steflayanto/Tricopter/Tricopter Specs.xlsx

Sheet: Technical Specs
 | Arduino Copter
Flight Weight (grams) | 825
Arm Radius (cm) | 30
Prop
Prop Centre Radius (cm) | 25.5
Prop Type | APC 6x4E LP0604E
Max Thrust (grams) | 1350 | Flight Time | Amps | AH | mAH
Theoretical Flight Time (seconds) | 2:00 - 3:25 | 5 | 12 | 3 | 3000
Flight Controller | Arduino Uno
Accelerometer | DFR Robot BMA220
Gyroscope | SparkFun ITG3200
Servo | KDS 9G Digital Servo
Output Torque | 1.4kg.cm(4.8V) @1.8kg.cm(6.0V)
Speed | 0.09sec/60(4.8V) @0.07sec/60(6.0V)
Rating Voltage | 4.8-6V
Operating Temperature | -20 - 60C
Weight | 9G
Dimensions | 24x12x24mm
Motor | A2212/6T 2200KV
Shaft diameter (mm) | 3
KV (RPM/V) | 2200
Max Efficiency Current (Amps) | 14 - 22
Max Current | 28A for 60s
No load current (Amps) | 1.2
Dimensions (cm) | 3.7 x 2.8 x 2.8
Weight (grams) | 49
Total Motors Current (Amps) | 42 - 66
Total Motors Max Current | 84A for 60s
Battery | UltraPulse LiPo
Cells | 3S (11.1V) | Note: Avoid Discharging Battery Below 80% C
Capacity (mAH) | 2200
Discharge Rate | 25C or 55A
Charge Rate | < 5C or < 11A
Weight (grams) | 200
Reciever | FlySky FS-R9B
Channels | 8
Frequency | 2.4GHz
Weight (grams) | 18
Transmitter | FlySky FS-TH9X
ESC | Ztw Beatles 30A ESC
Continuous Current (Amps) | 30
Burst Current (Amps) | 40
BEC Output | 5V/2A
Weight (grams) | 24
Charger
Charge Rate | 1-3A
Charge Time (1A)
Charge Time (2A) | 40:00:00
Charge Time (3A)

Sheet: Sheet1
Servo Neutral Position |  | 1370micros
Servo Range |  | 700-1835
Angle Range
Motor Arming |  | 770us interval
Servo Angles | Middle | 1400 | 420 | 1400
 | 35 | 980
 | -35 | 1820 | 420

Sheet: Radio PWM Ranges
Function | Channel | Min | Middle | Max
Throttle | 2 | 1055 | 1460 | 1885
Pitch | 4 | 1055 | 1460 | 1880
Roll | 3 | 1040 | 1460 | 1875
Yaw | 1 | 1045 | 1460 | 1875
Aux5 | 5 | 1025 | N/A | 1855
Aux6 | 6 | 1025 | 1445 | 1865

Sheet: Pin Assignments
Pin | Assignment | Description
0
1
2
~3 | Radio Ch1
4 | Radio Ch2
~5 | Radio Ch3
~6 | Left ESC
7 | Radio Ch4
8 | Radio Aux5
~9 | Right ESC
~10 | Back ESC
~11 | Back Servo
12
13
GND
3.3V
5V
GND
GND
Vin
A0
A1
A2
A3
A4
A5

Sheet: Thrust Stat Tests
Scale (0 - 1000) | Micros | Servo | Weight 1 | Weight 2 |  |  | Ave Weight | Thrust
0 | 700 | 0 | 1160 | 1160 |  |  | 1160 |  | Omitted
55.55555556 | 772.2222222 | 10 | 1160 | 1160 |  |  | 1160 |  | Omitted
111.1111111 | 844.4444444 | 20 | 1160 |  |  |  | 1160 |  | Omitted
166.6666667 | 916.6666667 | 30 | 1160 |  |  |  | 1160 | 0
222.2222222 | 988.8888889 | 40 | 1140 |  |  |  | 1140 | 20
277.7777778 | 1061.111111 | 50 | 1110 |  |  |  | 1110 | 50
333.3333333 | 1133.333333 | 60 | 1070 | 1050 |  |  | 1060 | 100
388.8888889 | 1205.555556 | 70 | 1040 | 1000 | 1020 |  | 1020 | 140
444.4444444 | 1277.777778 | 80 | 1000 | 1000 |  |  | 1000 | 160
500 | 1350 | 90 | 980 | 950 |  |  | 965 | 195
555.5555556 | 1422.222222 | 100 | 950 | 940 |  |  | 945 | 215
611.1111111 | 1494.444444 | 110 | 930 | 900 |  |  | 915 | 245
666.6666667 | 1566.666667 | 120 | 900 | 880 |  |  | 890 | 270
722.2222222 | 1638.888889 | 130 | 890 | 860 |  |  | 875 | 285
777.7777778 | 1711.111111 | 140 | 860 | 850 |  |  | 855 | 305
833.3333333 | 1783.333333 | 150 | 850 | 750 |  |  | 800 | 360
888.8888889 | 1855.555556 | 160 |  | 750 |  |  | 750 | 410
944.4444444 | 1927.777778 | 170 |  | 720 |  |  | 720 | 440
1000 | 2000 | 180 |  | 740 |  |  | 740 | 420
 | Prop | Volts | Amps | Watts | rpm | Thrust | Efficiency
 | APC 6x4E | 10.5 | 22 | 230 | 18786 | 680g | 75%
 | Source: http://www.bhabbott.net.nz/A2212-6.html
 | Experimental Max Amp Draw
 | Single Motor |  | 22A
 | Triple Motors |  | 66A

Sheet: Program
Name | Type | Category | Tabs Used In | Range | Description
centerOfThrust[2] | Float Array | Radio Input/PID | Main, Convert Output | -15.0 to 15.0 (for both axis) | Coordinates visualizing the center of thrust from a top down view of a 2 dimensional cartesian grid.
headingThrust | float | Output Conversions | Convert Output | -40.0 to 40.0 | Rotational Output force in % of total motor thrust. Limited to 40% since hovering thrust around 80%, and applying more than 40% rotational thrust will cause servo angle to exceed 30 deg

Sheet: Loop Speed
Baud Rate | 250000 |  |  |  | 115200
Loop Duration (microsec) | 1235 | 10800 | 11000 | 11700 | 11700
Frequency | 809.7165992 | 92.59259259 | 90.90909091 | 85.47008547 | 85.47008547 | #DIV/0! | #DIV/0! | #DIV/0! | #DIV/0! | #DIV/0! | #DIV/0! | #DIV/0! | #DIV/0! | #DIV/0! | #DIV/0! | #DIV/0! | #DIV/0! | #DIV/0! | #DIV/0! | #DIV/0! | #DIV/0! | #DIV/0! | #DIV/0! | #DIV/0!
Errors |  |  |  | Yes
Display Functions | Yes
getOrientation |  | Yes | Yes | Yes
CheckForInput |  |  | Yes | Yes
ReadRadioMAF |  |  |  | Yes
