steflayanto/Tricopter/References, Diagrams, Manuals/Propellers.pdf

FUND TRANSFER RECEIPT
Date | : | 25/08/2017
Time | : 16:36:44
Reference Number | : | 15AFC571-A2FC-5A56-0FAA-12D2274A1E6B
Virtual Account Number | : 80008081215524236
Name | : | Stefan Layanto
Company/Product Name | : BUKALAPAK
BL17114EHOKDINV | : | 134.500,00
Billing Total | : | 134.500,00
Sequence Number | : | 601900
Status | : | TRANSACTION SUCCESS
Copyright © 2000 | All Rights Reserved
