steflayanto/Tricopter/References, Diagrams, Manuals/Accel Graph Screenshots/Accel64Hz runningMAF15.png

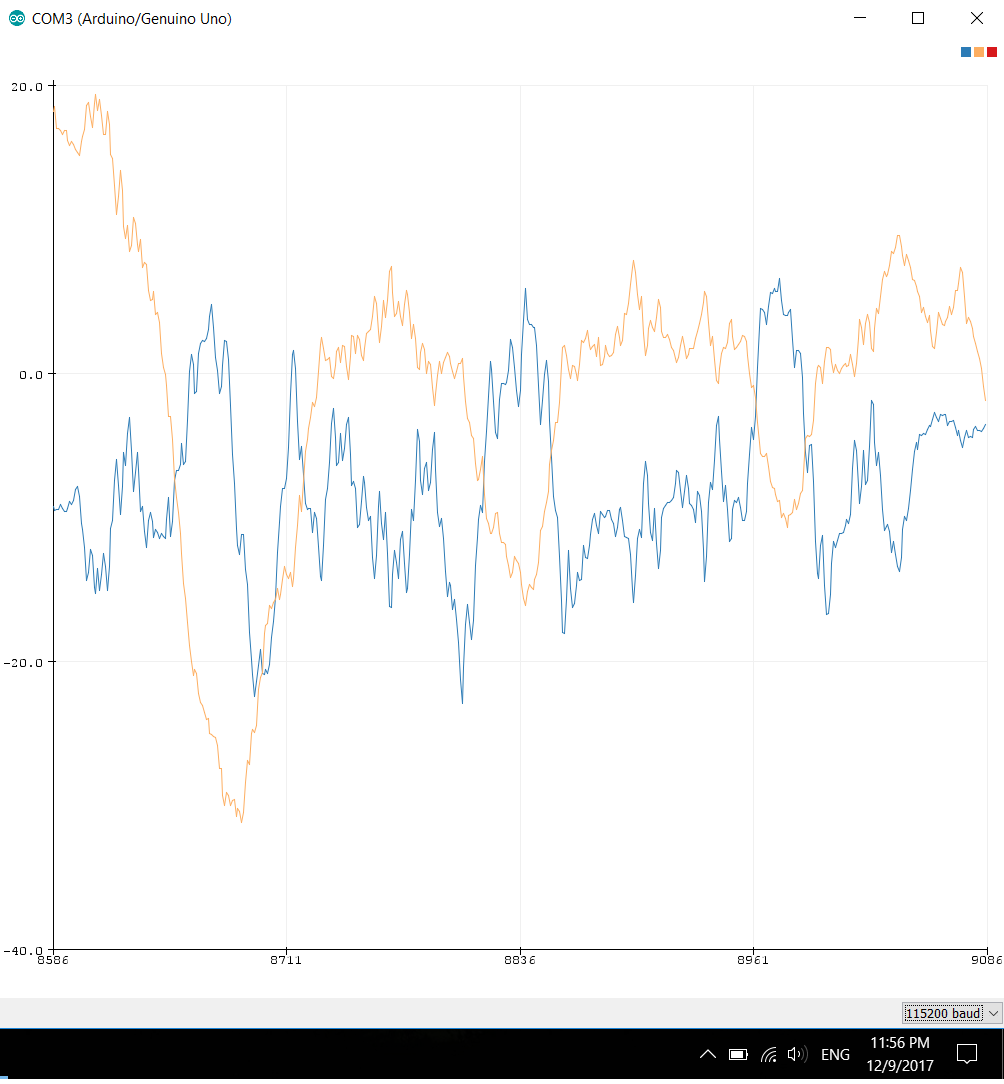
References, Diagrams, Manuals/Accel Graph Screenshots/Accel64Hz runningMAF15.png
