steflayanto/Tricopter/References, Diagrams, Manuals/Accel Graph Screenshots/Accel250Hz runningMAF15.png

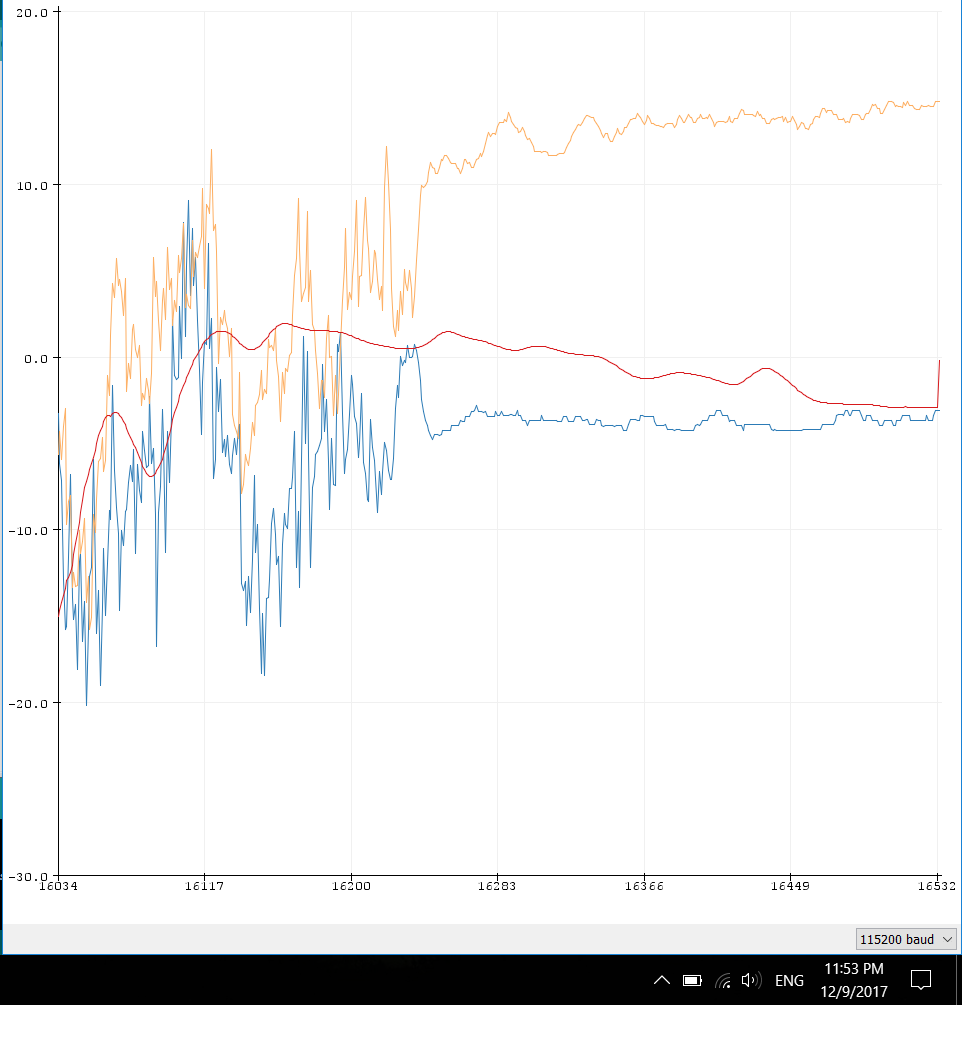
References, Diagrams, Manuals/Accel Graph Screenshots/Accel250Hz runningMAF15.png
