steflayanto/Tricopter/References, Diagrams, Manuals/Accel Graph Screenshots/Accel500Hz running MAF 30.png

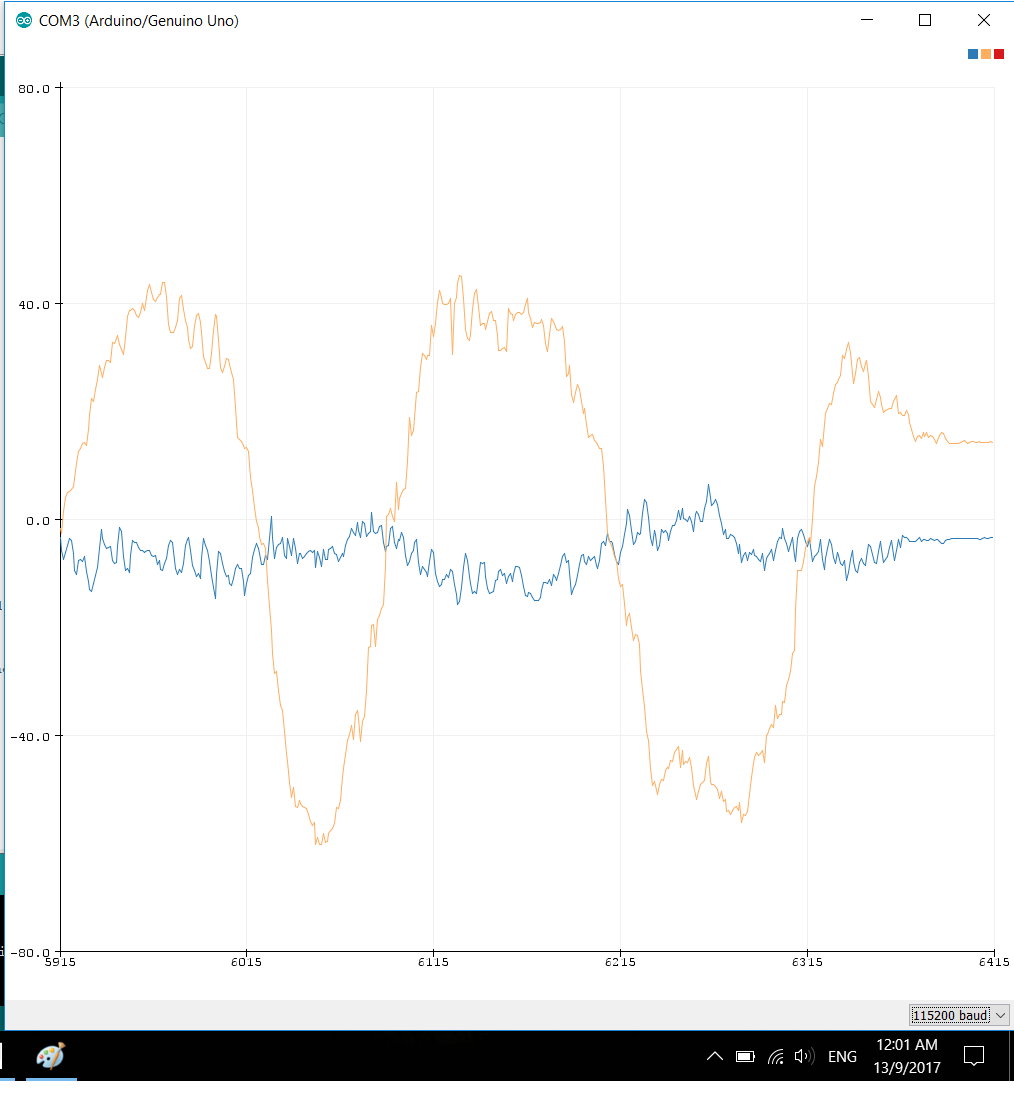
References, Diagrams, Manuals/Accel Graph Screenshots/Accel500Hz running MAF 30.png
