steflayanto/Tricopter/References, Diagrams, Manuals/Accel Graph Screenshots/Accel ForcedTilt 64Hz 10MAF.png

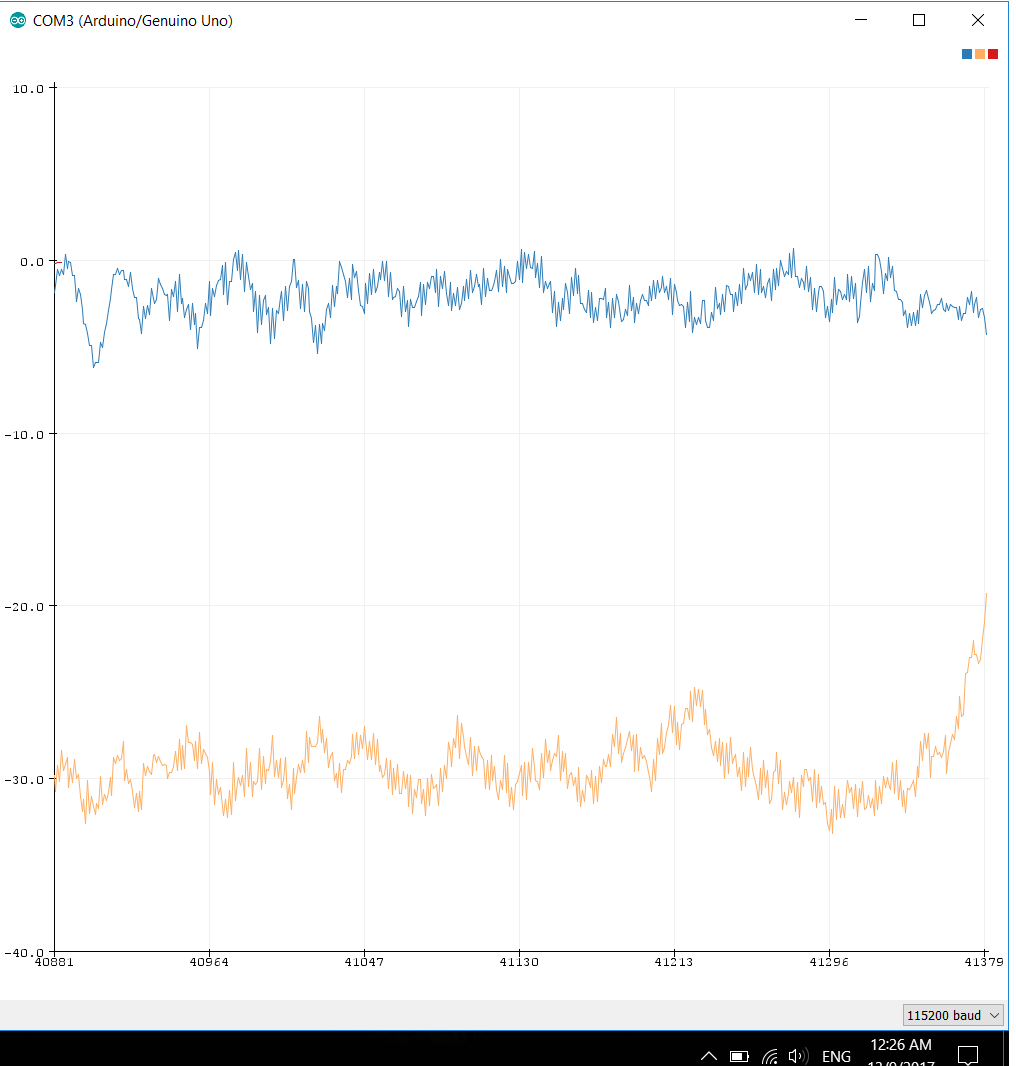
References, Diagrams, Manuals/Accel Graph Screenshots/Accel ForcedTilt 64Hz 10MAF.png
