steflayanto/Tricopter/References, Diagrams, Manuals/Accel Graph Screenshots/Accel ForcedTilt 125Hz 20MAF.png

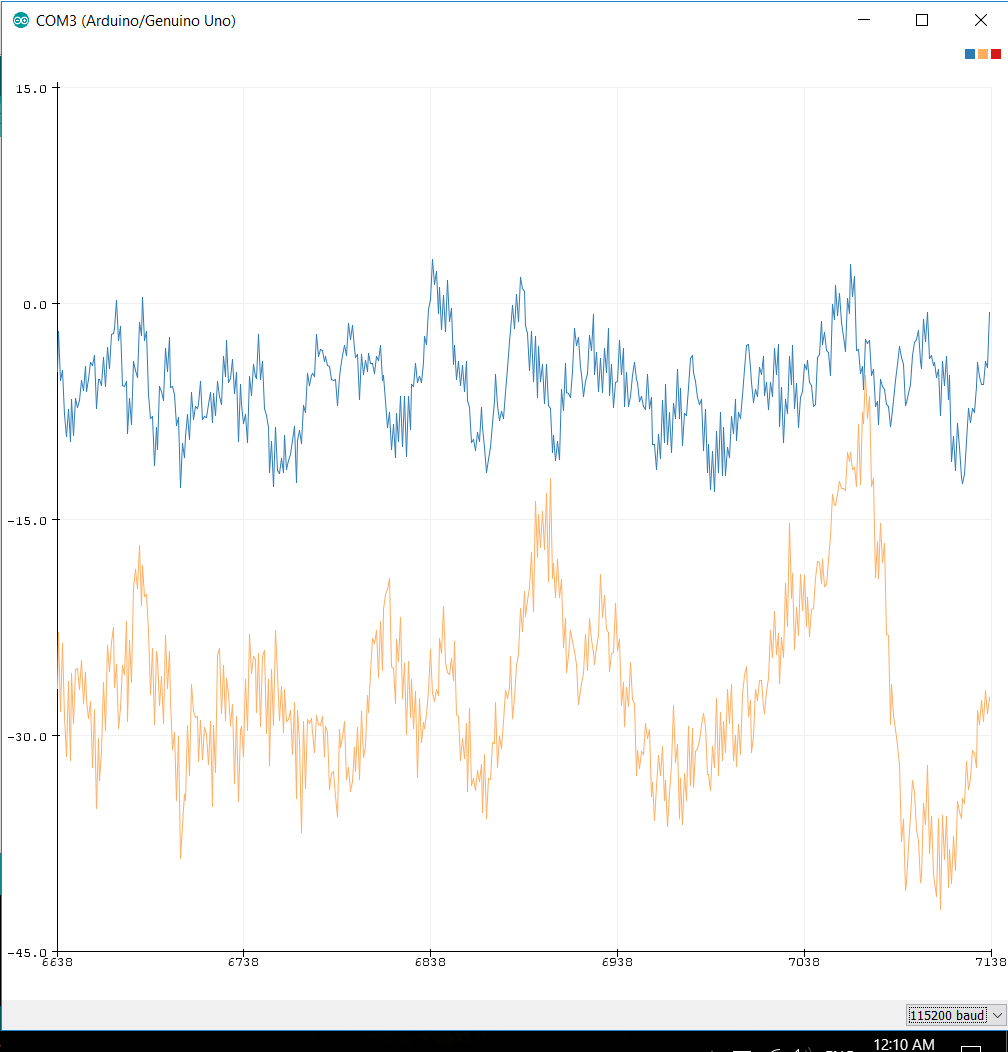
References, Diagrams, Manuals/Accel Graph Screenshots/Accel ForcedTilt 125Hz 20MAF.png
