steflayanto/Tricopter/References, Diagrams, Manuals/Accel Graph Screenshots/Accel ForcedTilt 250Hz 15MAF New Dampener.png

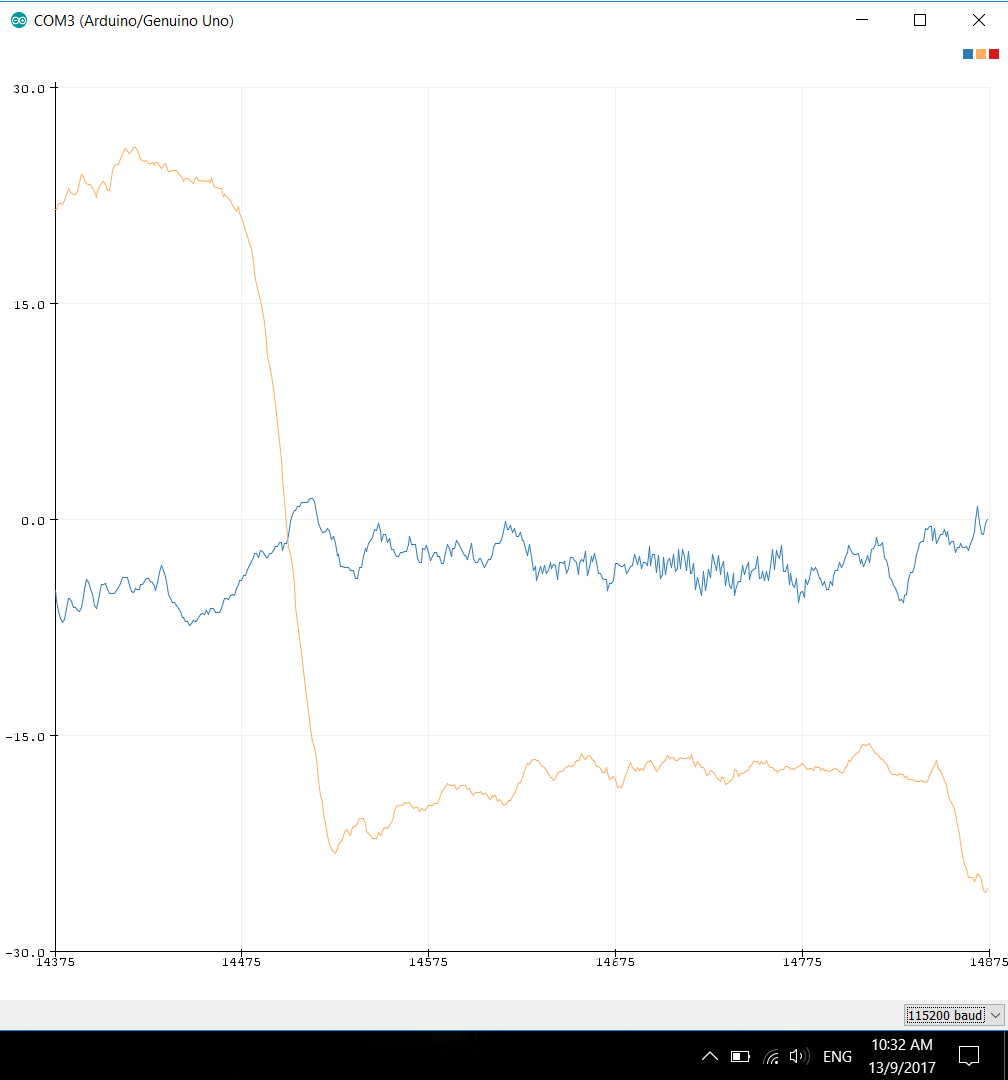
References, Diagrams, Manuals/Accel Graph Screenshots/Accel ForcedTilt 250Hz 15MAF New Dampener.png
