steflayanto/Tricopter/References, Diagrams, Manuals/Accel Graph Screenshots/Accel ForcedTilt 250Hz 20MAF.png

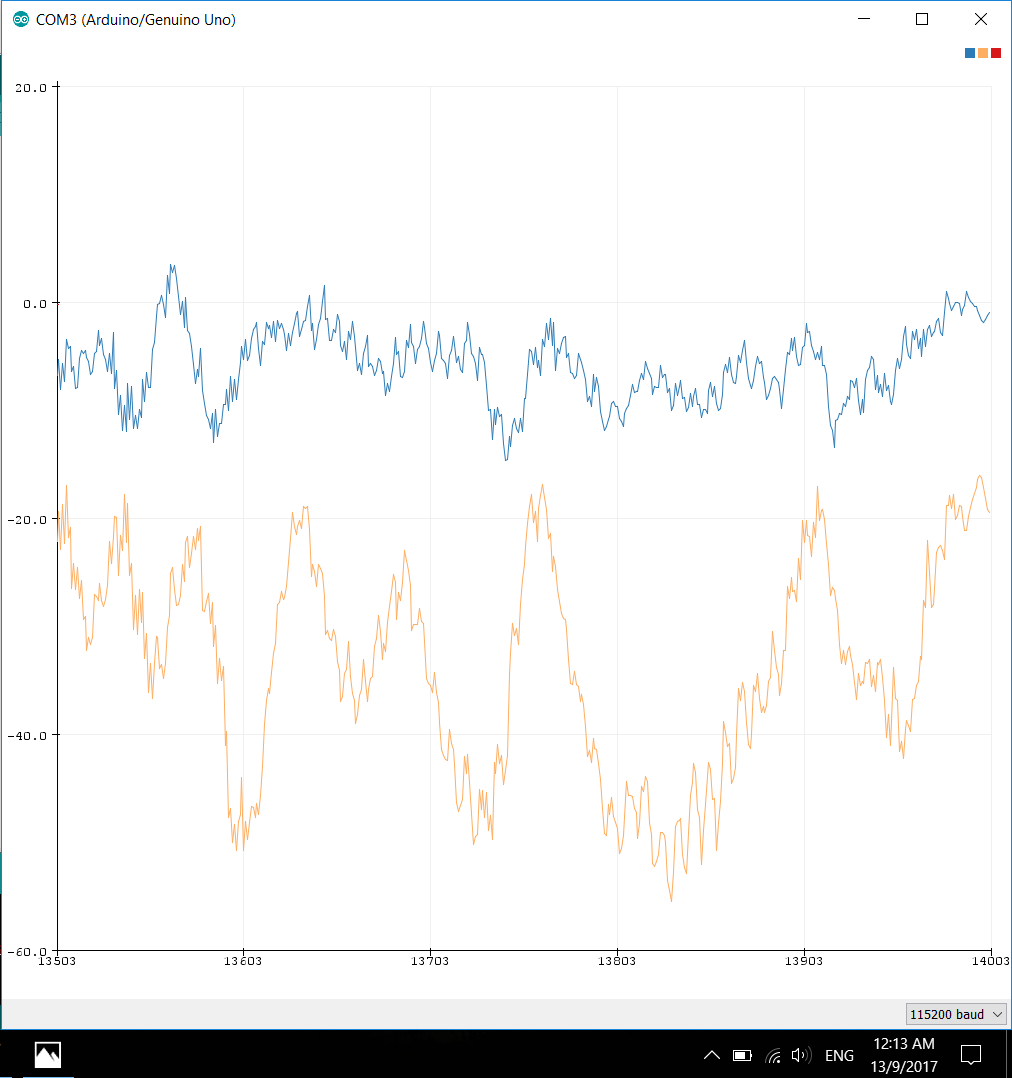
References, Diagrams, Manuals/Accel Graph Screenshots/Accel ForcedTilt 250Hz 20MAF.png
