steflayanto/Tricopter/References, Diagrams, Manuals/Accel Graph Screenshots/Accel ForcedTilt 500Hz 20MAF.png

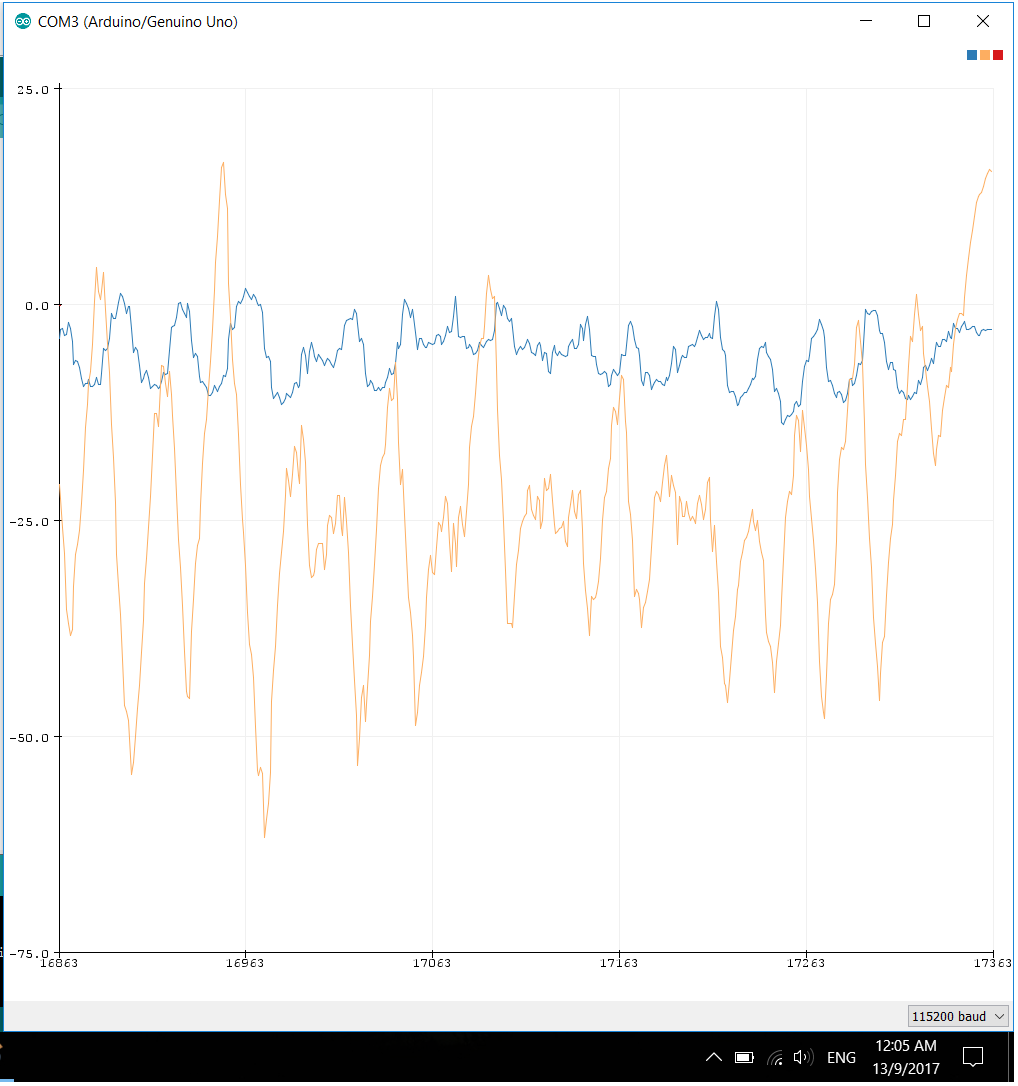
References, Diagrams, Manuals/Accel Graph Screenshots/Accel ForcedTilt 500Hz 20MAF.png
