steflayanto/Tricopter/References, Diagrams, Manuals/Accel Graph Screenshots/Resting Accel Data 100 Hz Sample.png

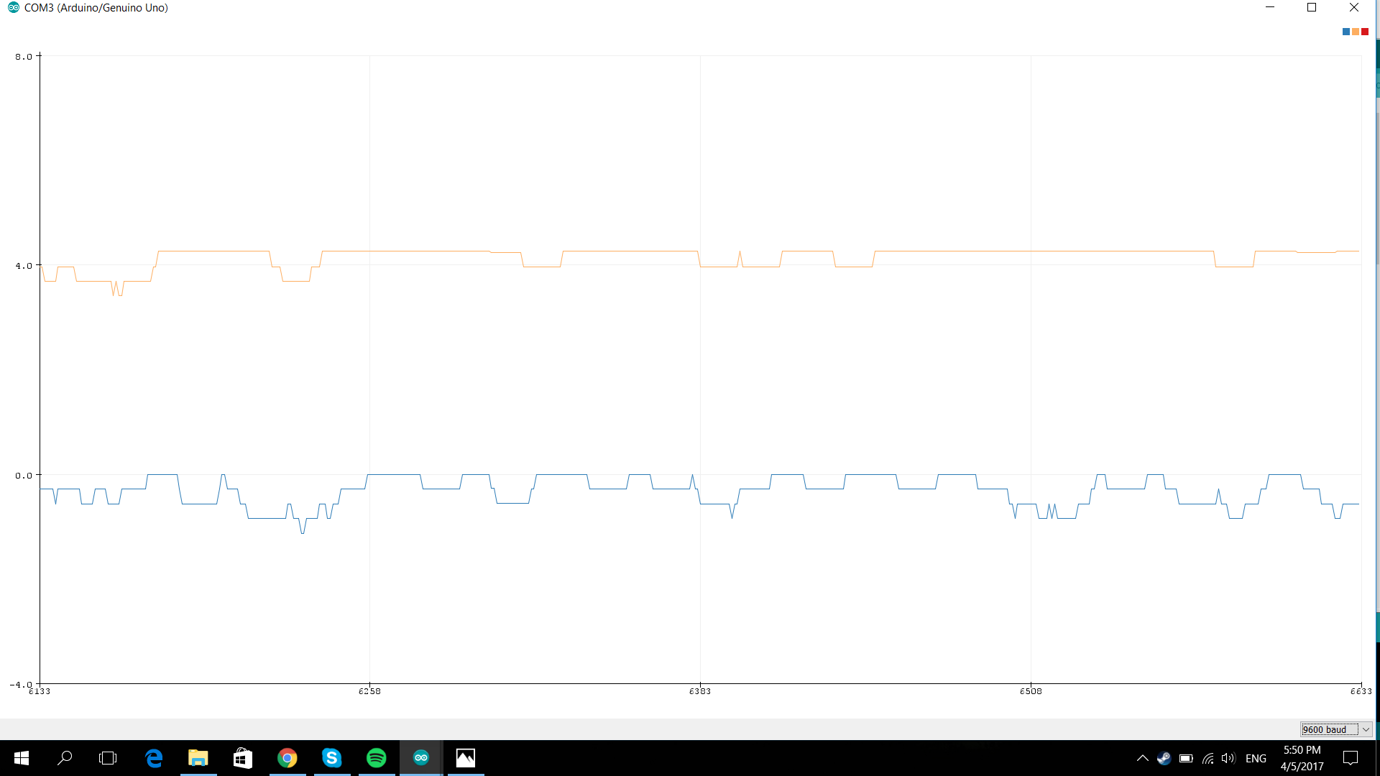
References, Diagrams, Manuals/Accel Graph Screenshots/Resting Accel Data 100 Hz Sample.png
