steflayanto/Tricopter/References, Diagrams, Manuals/Accel Graph Screenshots/Resting Accel Data 250 Hz Sample.png

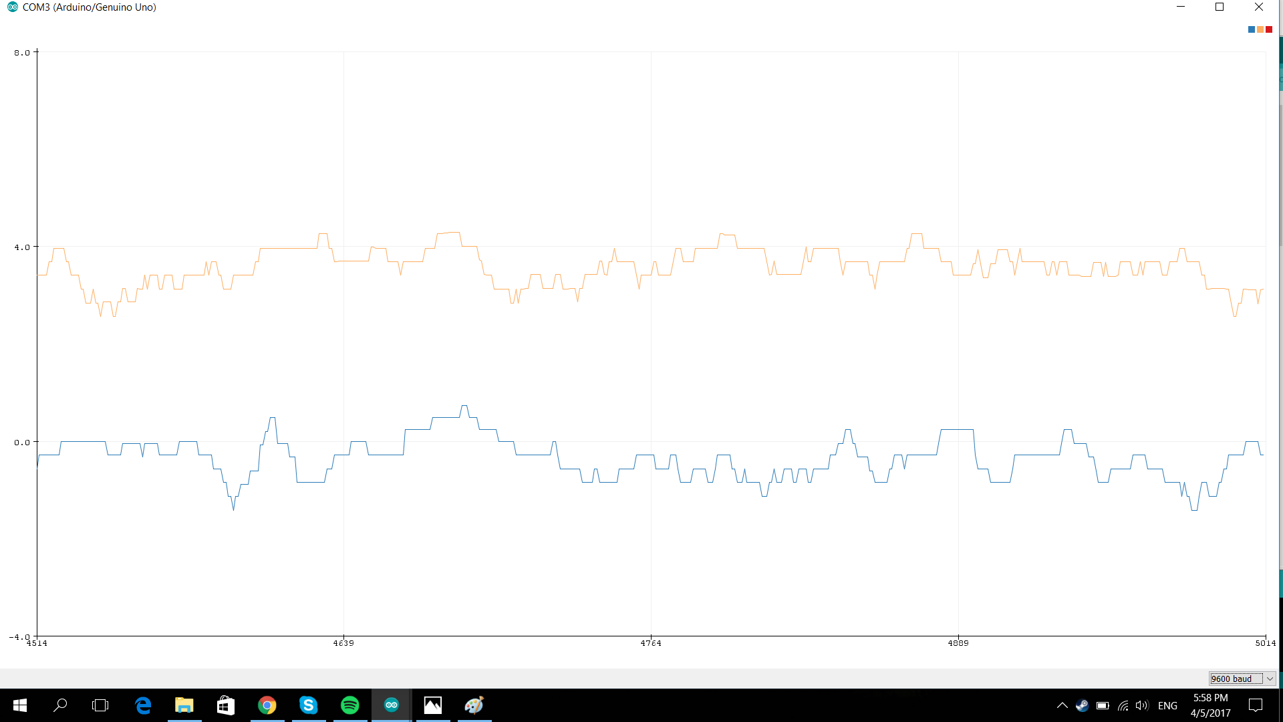
References, Diagrams, Manuals/Accel Graph Screenshots/Resting Accel Data 250 Hz Sample.png
