steflayanto/Tricopter/References, Diagrams, Manuals/Accel Graph Screenshots/Resting Accel Data 500 Hz Sample.png

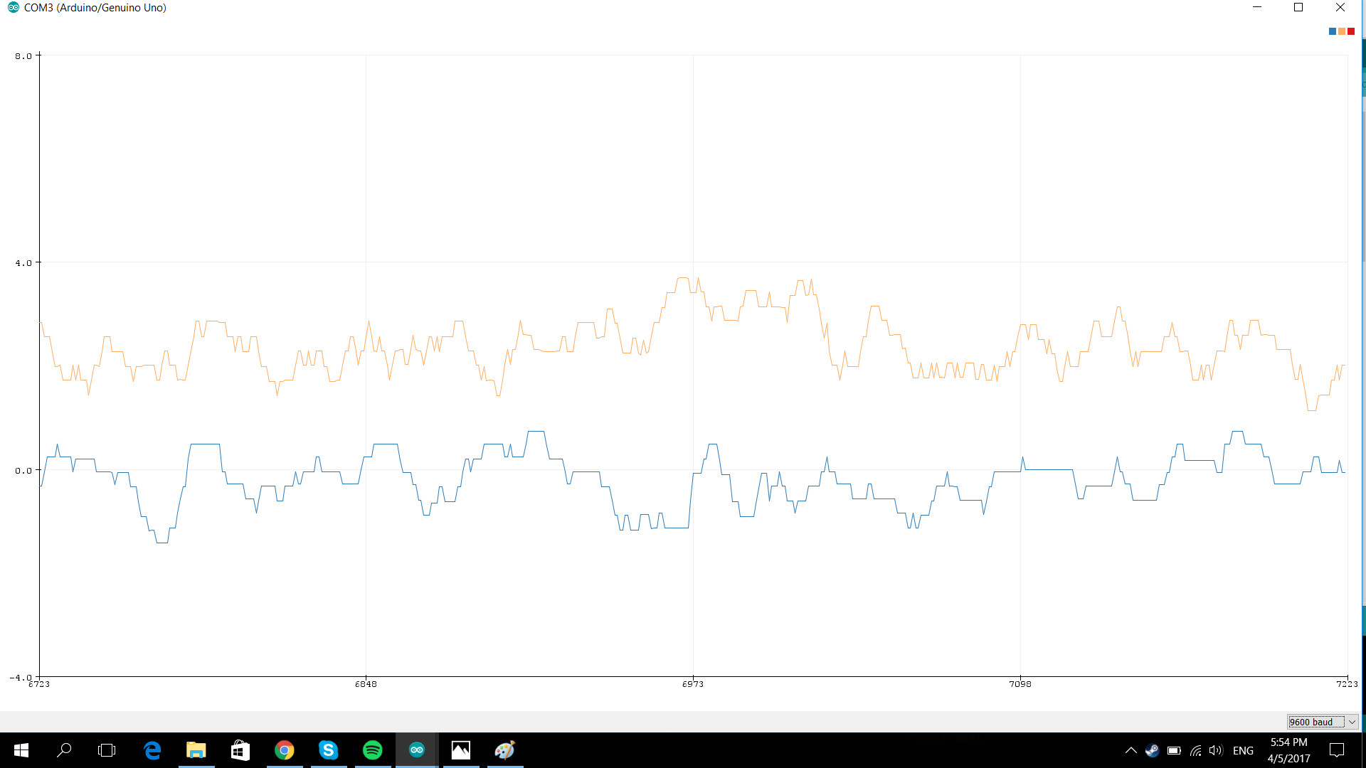
References, Diagrams, Manuals/Accel Graph Screenshots/Resting Accel Data 500 Hz Sample.png
