steflayanto/Tricopter/References, Diagrams, Manuals/Center Of Thrust Grid (Visualization).png

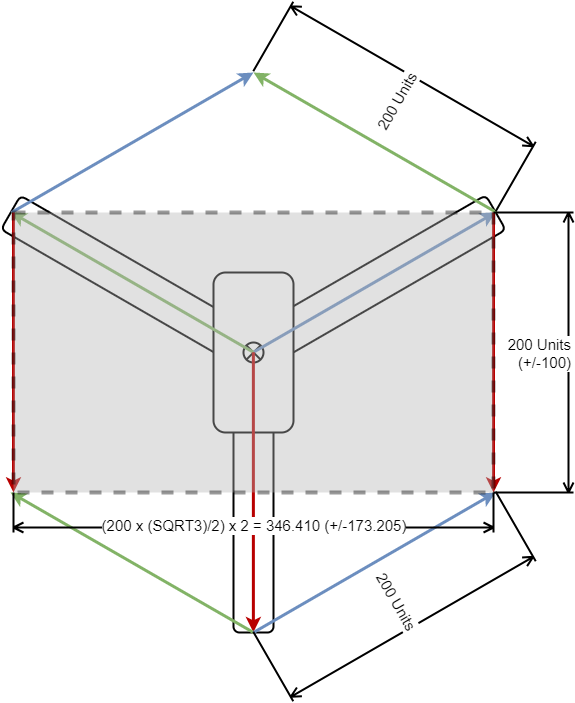
References, Diagrams, Manuals/Center Of Thrust Grid (Visualization).png
