steflayanto/Tricopter/Tricopter Stationary Tests.xlsx

Sheet: Sheet1
Combined Thrust Test Data
Weakest Prop. Estimated Peak Thrust: |  |  | 480 |  |  |  |  |  |  |  |  |  |  | Maximum | 1245
Left Prop |  |  |  | Right Prop |  |  | Back Prop |  |  |  |  | Back Prop Angles
Signal (micros) | Weight (grams) | Thrust (grams) | Before Swap | Signal (micros) | Weight (grams) | Thrust (grams) | Signal (micros) | Weight (grams) | Thrust (grams) | Before Swap | Index | PropSignal | ServoSignal | Weight | VertThrust | Theoretical Thrust | Percentage of Theoretical Thrust | Inverse of %Thrust
710 | 1936 |  | 0 | 702 | 1900 | 0 | 702 | 1786 |  | 0 | 1 | 702 | 1350 | 1833 | 0 | 0
702 | 1908 |  | 28 | 865 | 1845 | 55 | 770 | 1781 |  | 5 | 2 | 870 | 1351 | 1797 | 36 | 36 | 100.00% | 1
781 | 1907 |  | 29 | 1030 | 1733 | 167 | 885 | 1706 |  | 80 | 3 | 870 | 1475 | 1804 | 29 | 36 | 80.56% | 1.24137931
940 | 1868 |  | 68 | 1285 | 1577 | 323 | 975 | 1686 |  | 100 | 4 | 870 | 1566 | 1808 | 25 | 36 | 69.44% | 1.44
1110 | 1816 |  | 120 | 1517 | 1484 | 416 | 870 | 1719 |  | 67 | 5 | 870 | 1666 | 1809 | 24 | 36 | 66.67% | 1.5
1295 | 1757 |  | 179 | 1707 | 1418 | 482 | 985 | 1630 |  | 156 | 6 | 870 | 1133 | 1798 | 35 | 36 | 97.22% | 1.028571429
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
